jedbaechler/ECE561Final/Small PCB/Small_PCB/Small_PCB.kicad_pcb

## KiCad design Small PCB/Small_PCB/Small_PCB.kicad_pcb (2024-05-05)

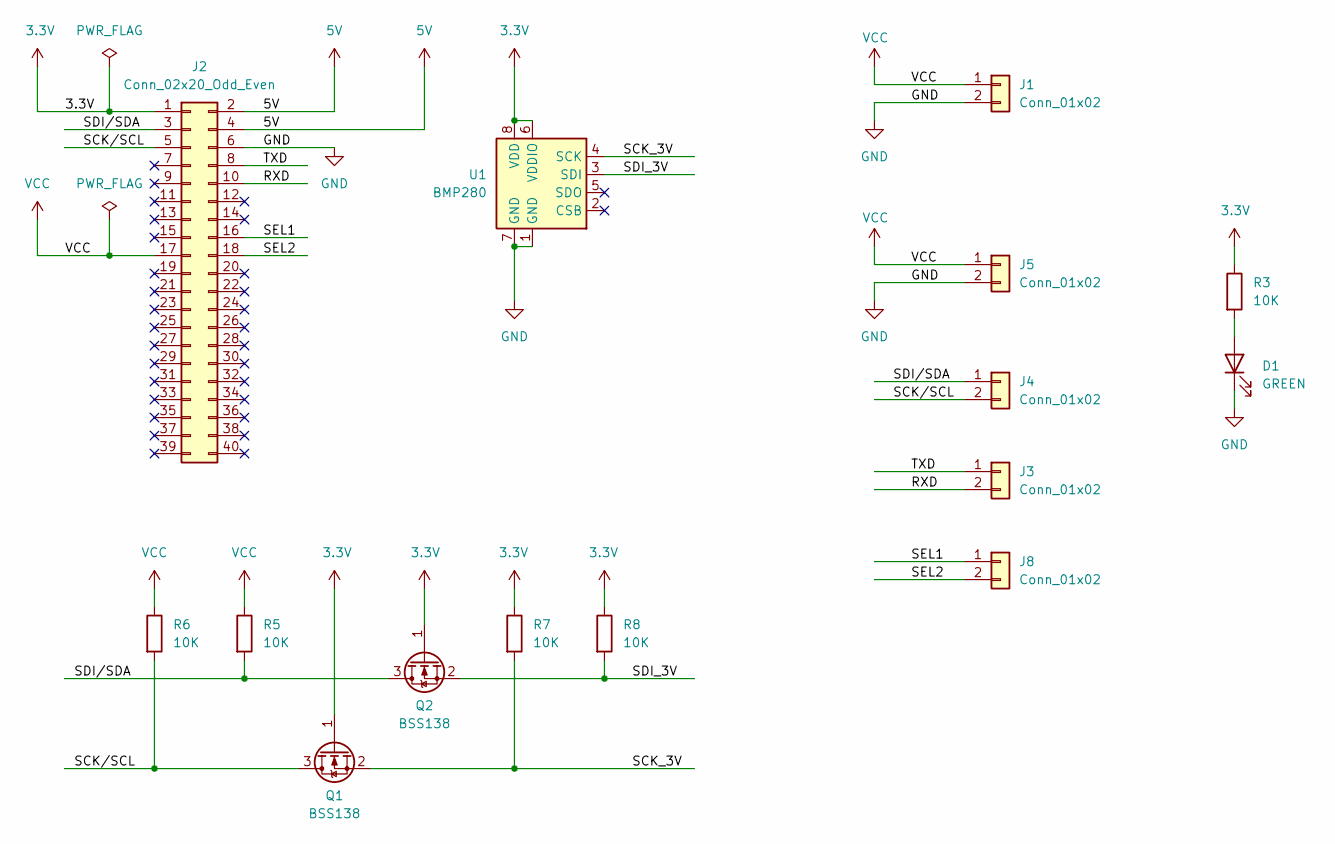
[picture p26: schematic Small_PCB.kicad_sch]

Parts:
D1: GREEN; LED_0805_2012Metric
J1, J3, J4, J5, J8: Conn_01x02; JST_EH_B2B-EH-A_1x02_P2.50mm_Vertical
J2: Conn_02x20_Odd_Even; PinSocket_2x20_P2.54mm_Vertical
Q1, Q2: BSS138; SOT-23
R3, R5, R6, R7, R8: 10K; R_0201_0603Metric
U1: BMP280; Bosch_LGA-8_2x2.5mm_P0.65mm_ClockwisePinNumbering

Connections:
3.3V: J2.1, Q1.1 (G), Q2.1 (G), R3.1, R7.1, R8.1, U1.6 (VDDIO), U1.8 (VDD)
5V: J2.2, J2.4
/RXD: J2.10, J3.2
/SCK_3V: Q1.2 (S), R7.2, U1.4 (SCK)
/SCK/SCL: J2.5, J4.2, Q1.3 (D), R6.2
/SDI_3V: Q2.2 (S), R8.2, U1.3 (SDI)
/SDI/SDA: J2.3, J4.1, Q2.3 (D), R5.2
/SEL1: J2.16, J8.1
/SEL2: J2.18, J8.2
/TXD: J2.8, J3.1
GND: D1.1 (K), J1.2, J2.6, J5.2, U1.1 (GND), U1.7 (GND)
unnamed: D1.2 (A), R3.2
VCC: J1.1, J2.17, J5.1, R5.1, R6.1

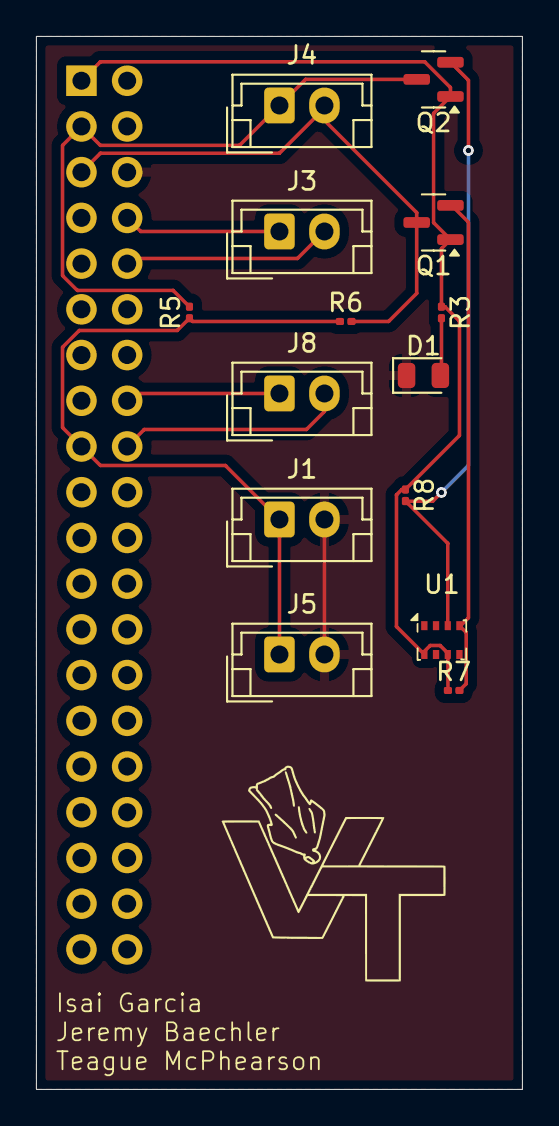
[picture p27: board Small_PCB.kicad_pcb from above]

Board: 2 copper layers, 27.0 x 58.5 mm, 15 parts (1 on the bottom side), 13 nets.
