jedbaechler/ECE561Final/Main PCB/Altitude Project.kicad_pcb

## KiCad design Main PCB/Altitude Project.kicad_pcb (2024-05-05)

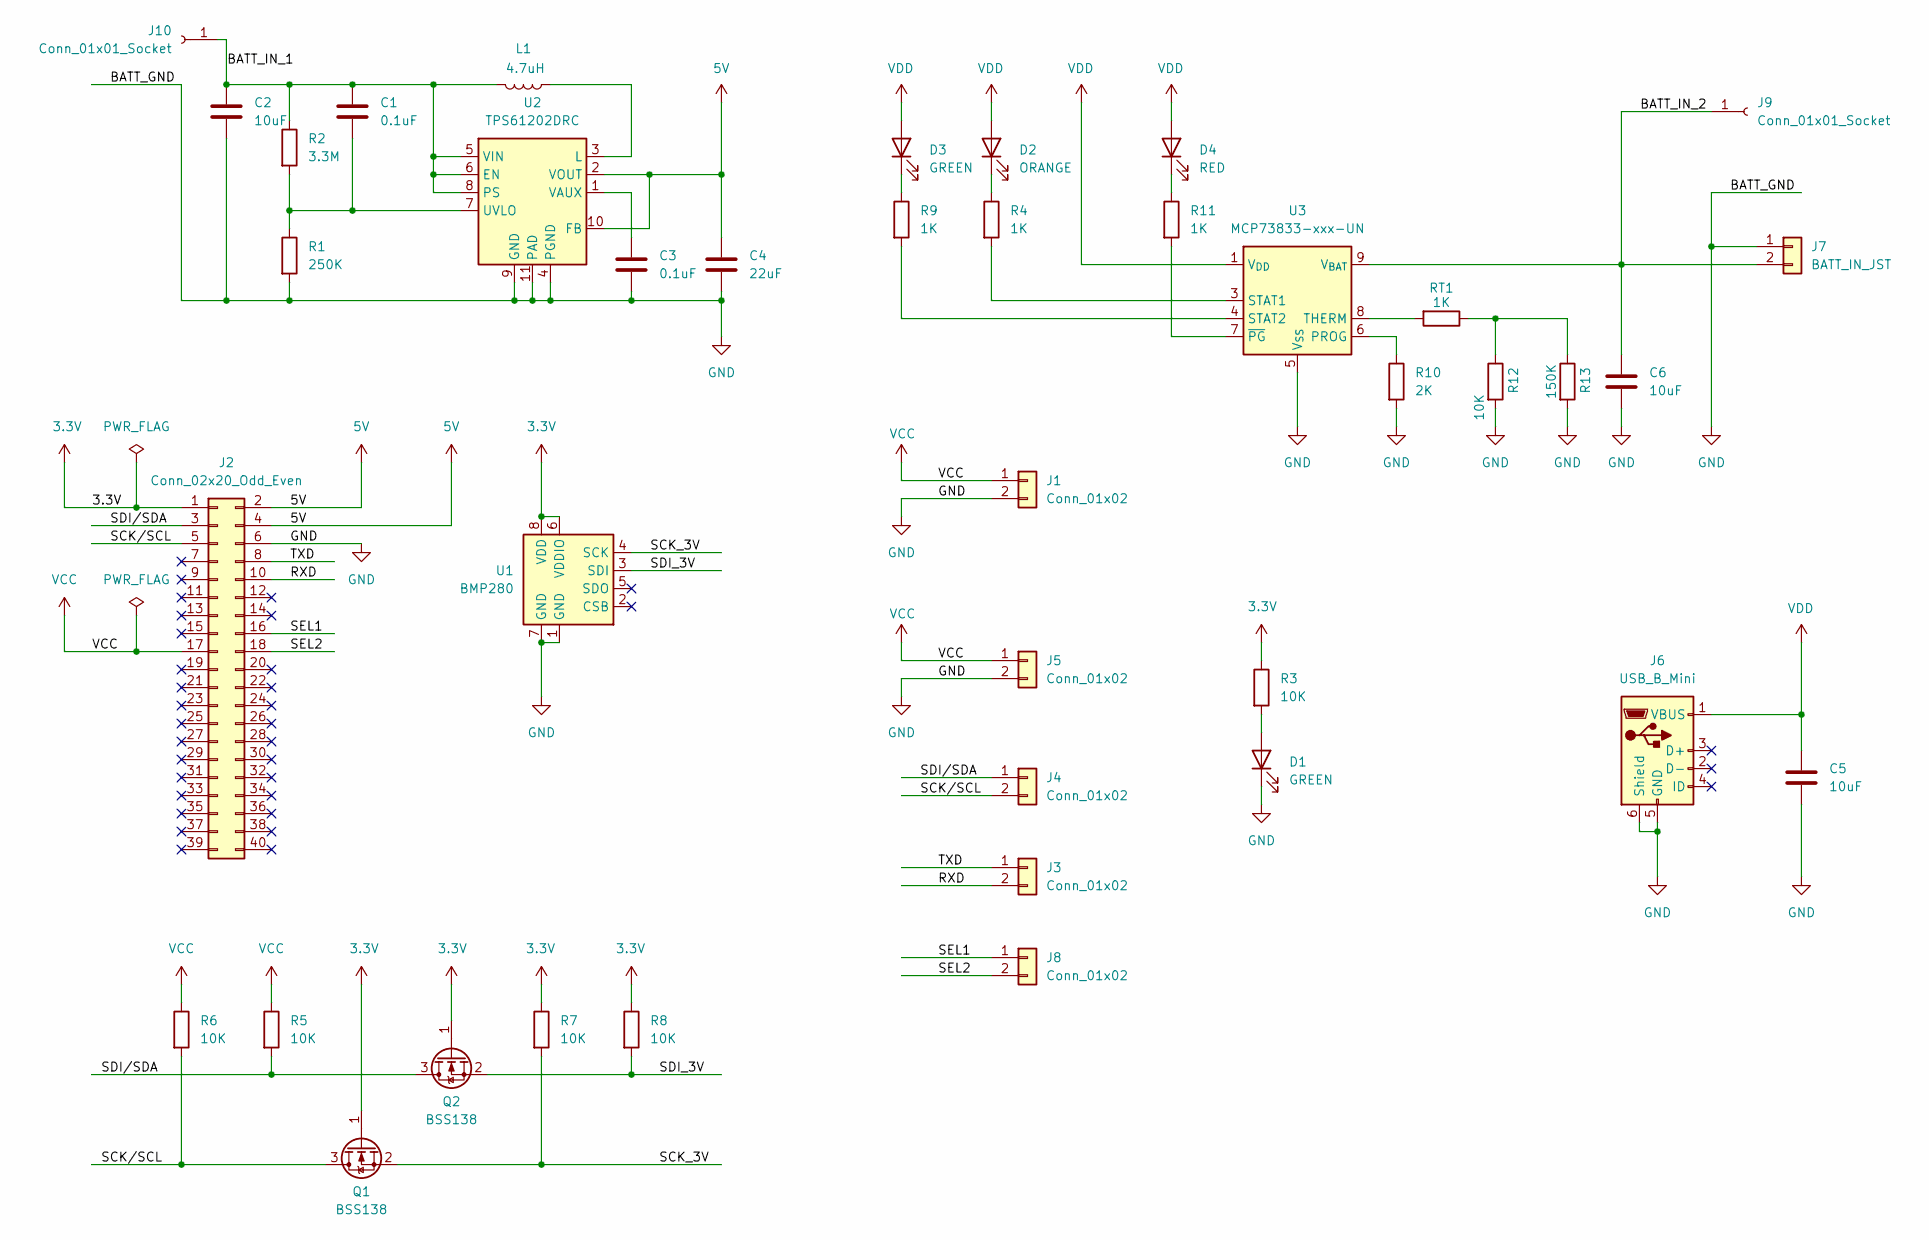
[picture p28: schematic Altitude Project.kicad_sch]

Parts:
C1, C3: 0.1uF; C_0402_1005Metric
C2, C5, C6: 10uF; C_0402_1005Metric
C4: 22uF; C_0402_1005Metric
D1, D3: GREEN; LED_0805_2012Metric
D2: ORANGE; LED_0805_2012Metric
D4: RED; LED_0805_2012Metric
J1, J3, J4, J5, J8: Conn_01x02; JST_EH_B2B-EH-A_1x02_P2.50mm_Vertical
J2: Conn_02x20_Odd_Even; PinSocket_2x20_P2.54mm_Vertical
J6: USB_B_Mini; USB_Mini-B_Lumberg_2486_01_Horizontal
J7: BATT_IN_JST; JST_EH_S2B-EH_1x02_P2.50mm_Horizontal
J9, J10: Conn_01x01_Socket; TestPoint_THTPad_2.0x2.0mm_Drill1.0mm
L1: 4.7uH; L_Changjiang_FNR4020S
Q1, Q2: BSS138; SOT-23
R1: 250K; R_0201_0603Metric
R2: 3.3M; R_1206_3216Metric
R3, R5, R6, R7, R8, R12: 10K; R_0201_0603Metric
R4, R9, R11: 1K; R_0201_0603Metric
R10: 2K; R_0201_0603Metric
R13: 150K; R_0201_0603Metric
RT1: 1K; R_0201_0603Metric
U1: BMP280; Bosch_LGA-8_2x2.5mm_P0.65mm_ClockwisePinNumbering
U2: TPS61202DRC; Texas_S-PVSON-N10_ThermalVias
U3: MCP73833-xxx-UN; MSOP-10_3x3mm_P0.5mm

Connections:
3.3V: J2.1, Q1.1 (G), Q2.1 (G), R3.1, R7.1, R8.1, U1.6 (VDDIO), U1.8 (VDD)
5V: C4.1, J2.2, J2.4, U2.2 (VOUT), U2.10 (FB)
/BATT_IN_1: C1.1, C2.1, J10.1, L1.2, R2.1, U2.5 (VIN), U2.6 (EN), U2.8 (PS)
/BATT_IN_2: C6.1, J7.2, J9.1, U3.9 (V_{BAT}), U3.10 (V_{BAT})
/RXD: J2.10, J3.2
/SCK_3V: Q1.2 (S), R7.2, U1.4 (SCK)
/SCK/SCL: J2.5, J4.2, Q1.3 (D), R6.2
/SDI_3V: Q2.2 (S), R8.2, U1.3 (SDI)
/SDI/SDA: J2.3, J4.1, Q2.3 (D), R5.2
/SEL1: J2.16, J8.1
/SEL2: J2.18, J8.2
/TXD: J2.8, J3.1
GND: C2.2, C3.2, C4.2, C5.2, C6.2, D1.1 (K), J1.2, J2.6, J5.2, J6.5 (GND), J6.6 (Shield), J7.1, R1.2, R10.2, R12.2, R13.2, U1.1 (GND), U1.7 (GND), U2.4 (PGND), U2.9 (GND), U2.11 (PAD), U3.5 (V_{SS})
unnamed: D1.2 (A), R3.2
unnamed: D2.1 (K), R4.1
unnamed: D3.1 (K), R9.1
unnamed: D4.1 (K), R11.1
unnamed: R12.1, R13.1, RT1.1
unnamed: L1.1, U2.3 (L)
unnamed: C1.2, R1.1, R2.2, U2.7 (UVLO)
unnamed: C3.1, U2.1 (VAUX)
unnamed: R10.1, U3.6 (PROG)
unnamed: R4.2, U3.3 (STAT1)
unnamed: R9.2, U3.4 (STAT2)
unnamed: RT1.2, U3.8 (THERM)
unnamed: R11.2, U3.7 (~PG)
VCC: J1.1, J2.17, J5.1, R5.1, R6.1
VDD: C5.1, D2.2 (A), D3.2 (A), D4.2 (A), J6.1 (VBUS), U3.1 (V_{DD}), U3.2 (V_{DD})

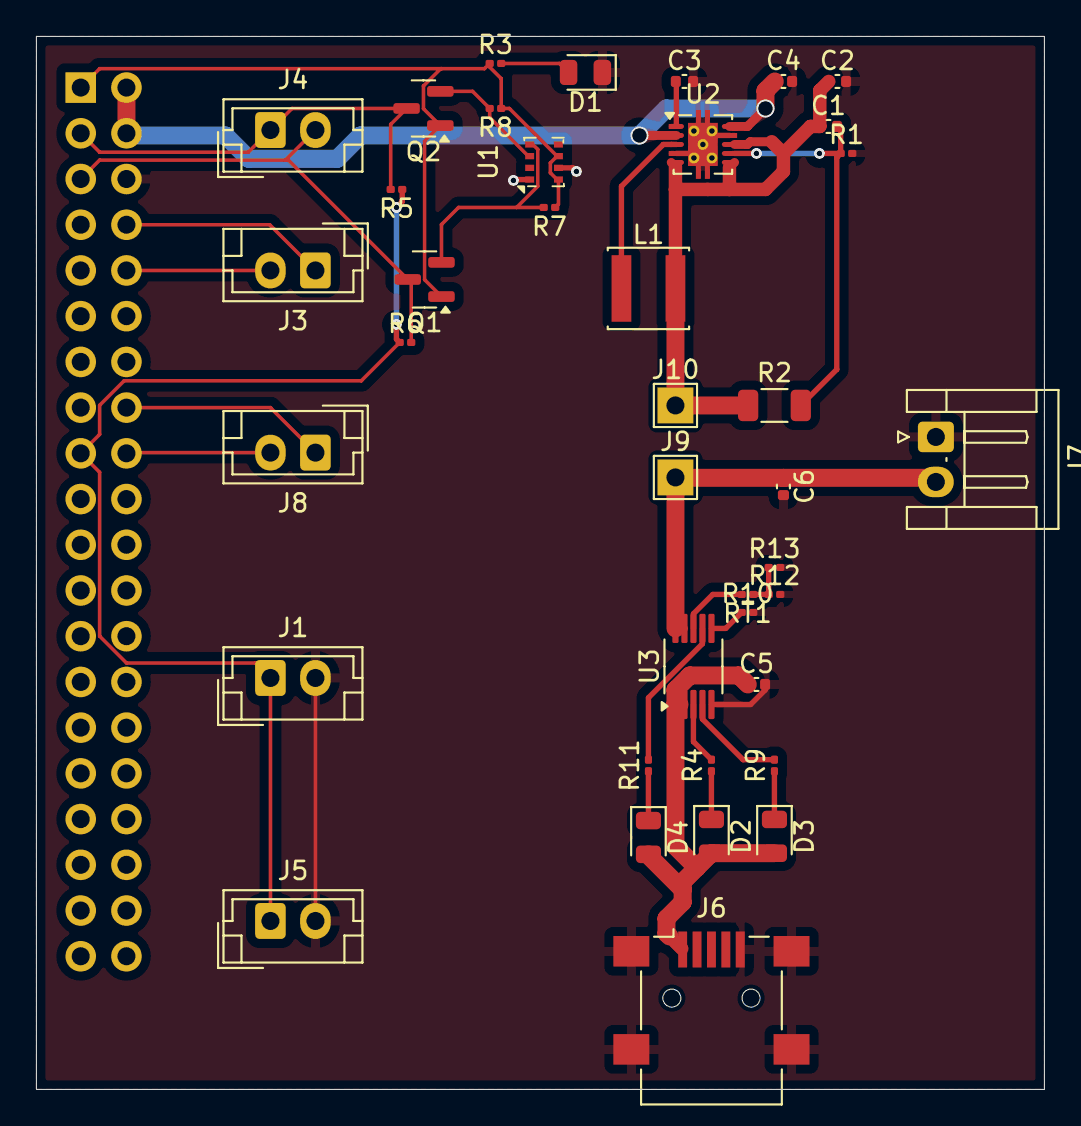
[picture p29: board Altitude Project.kicad_pcb from above]

Board: 2 copper layers, 56.0 x 58.5 mm, 40 parts (1 on the bottom side), 28 nets.
