jedbaechler/ECE561Final/(commit log)

2024-05-05 Final Code and Schematic Upload
    [Altitude BOM.csv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]
2024-05-05 Suppl. Materials
